valvinc/LEDruino-1.0/README.md

# LEDruino-1.0
Es empfiehlt sich das grosse Flussdiagram unter \grafiken\Fertig\ zum Verständnis zu studieren.
