valvinc/LEDruino-1.0/Arduino_Projektpräsentation.pdf

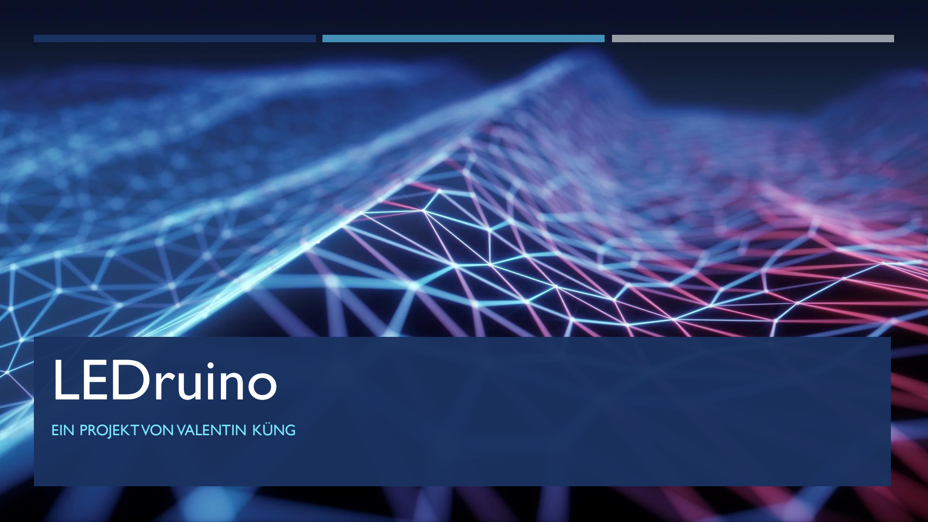
[picture p7: page 1]

# LEDruino

EIN PROJEKT VON VALENTIN KÜNG

### INHALT

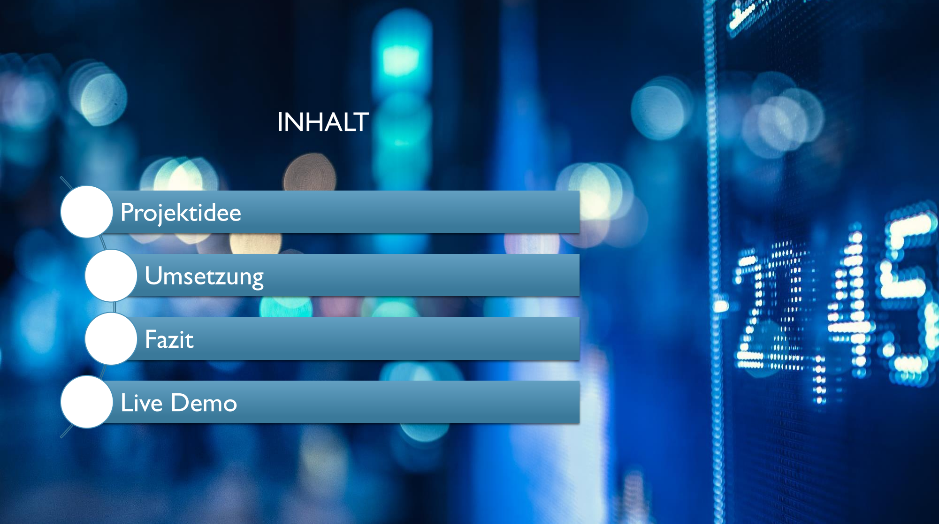
[picture p8: page 2]

### Projektidee

### Umsetzung

### Fazit

### Live Demo

### PROJEKTIDEE

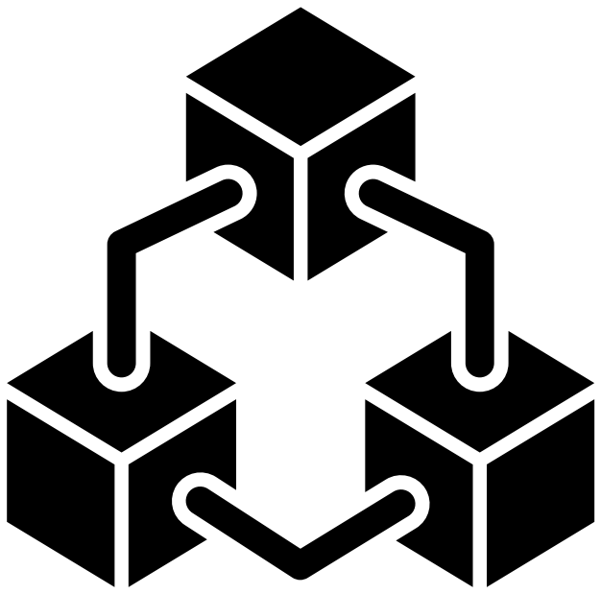
[picture p9: figure]

### PROJEKTIDEE

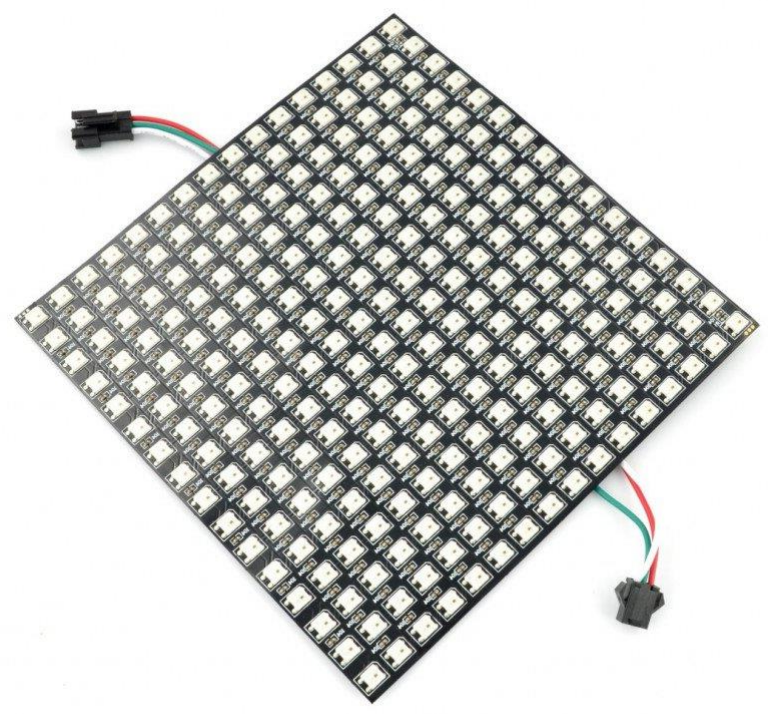
[picture p10: figure]

- LED-Kunstinstallation
- 16x16-LED-Matrix gesteuert von einem Arduino.
- Reaktion auf Umwelteinflüsse
- Kombination von Funktionalität und Ästhetik

### PLANUNG - FUNKTIONEN

- Anzeige von
- Nähe eines Objekts
- Licht
- Temperatur
- Geräusche
- Modi für einzelne Sensorendaten
- Modus für alle Sensorendaten zusammengefasst

### UMSETZUNG

### UMSETZUNG -WICHTIGE MODULE

- Hauptitereation - Setup() und Loop()
- LED und Sensoren Manager
- Inputs von Sensoren etc.
- Modi: Modul für Modi

### VEREINFACHTES FLUSSDIAGRAMM

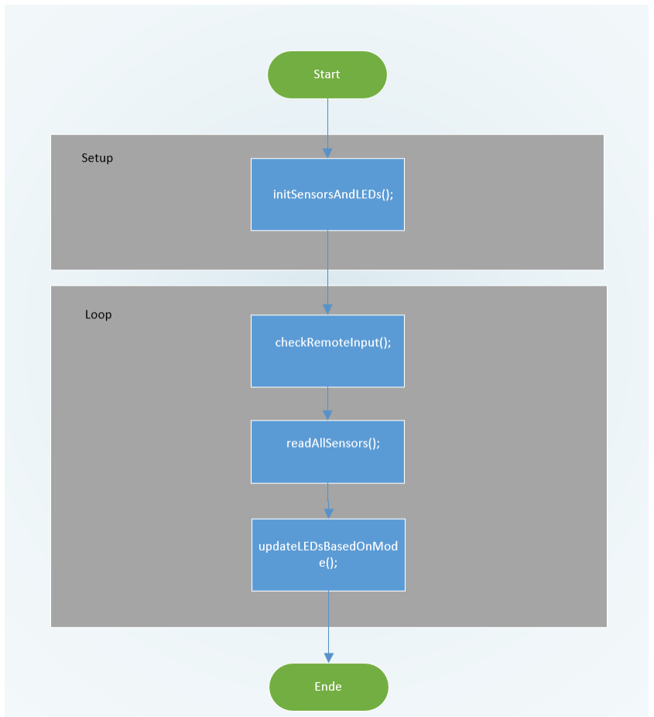
[picture p11: figure]

### UMSETZUNG - PHYSISCH

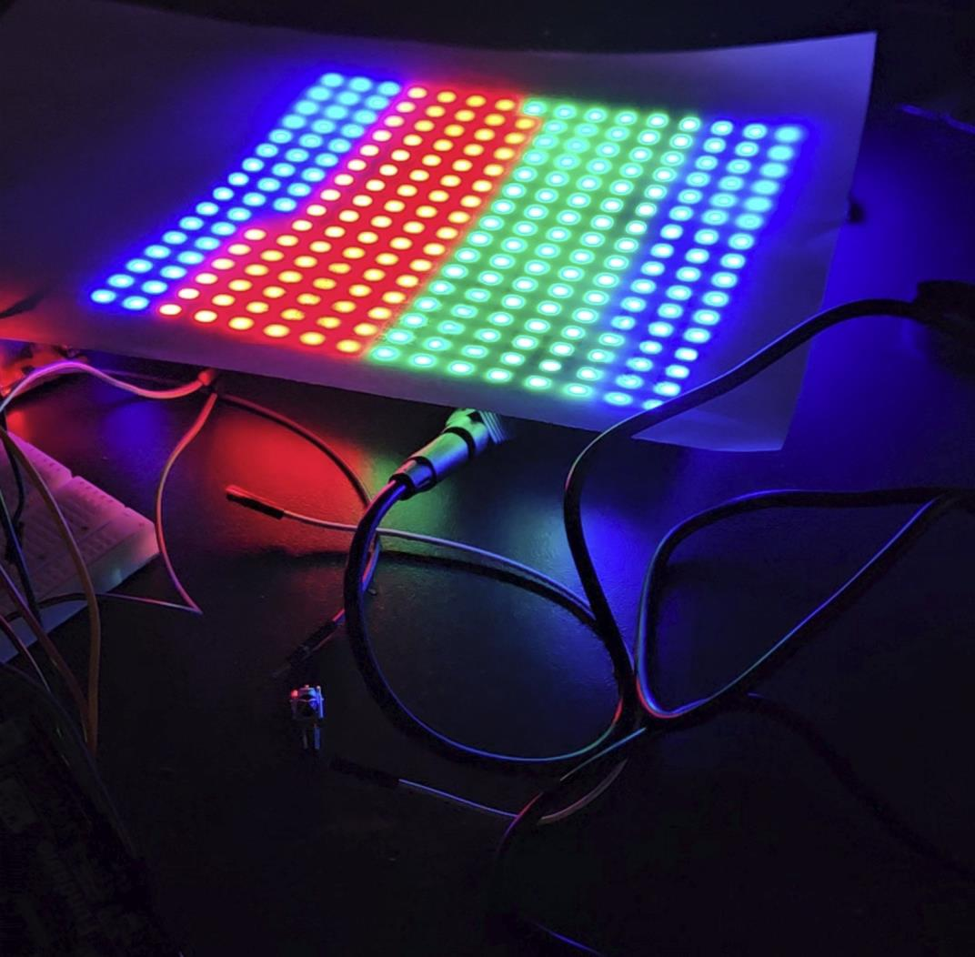
[picture p12: figure]

- Verkabelung
- Keypad
- Sensoren
- LED Matrix
- Stromversorgung LEDs

### UMSETZUNG – HERAUSFORDERUNGEN

- Echtzeitreaktion bei mehreren Sensoren
- Wertebereiche der Sensoren

### FAZIT

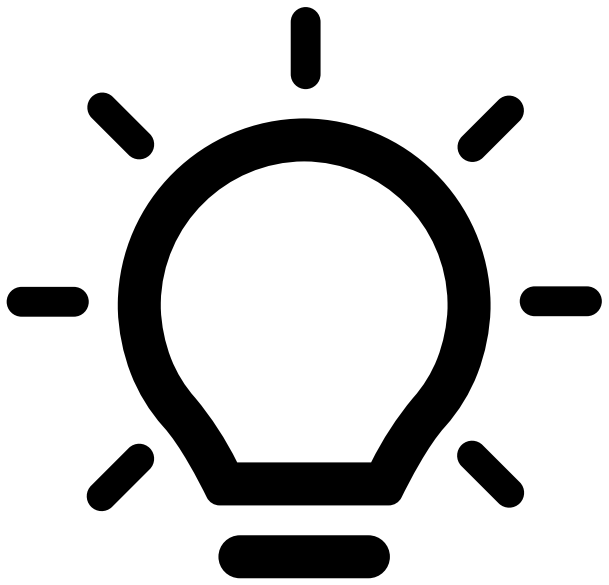
[picture p13: figure]

### FAZIT - ERKENNTNISSE

- Modulare Programmierung für einfache Erweiterungen
- Komplexität von innerhalb des Codes ist nicht zu unterschätzen
- Bedeutung von Zeitmanagement innerhalb des Codes

### FAZIT - ZUKUNFT

- Erstellung eines 3D-gedruckten Gehäuses
- Erweiterung um weitere Sensoren
- Animationen ausbauen

## LIVE DEMO
