valvinc/LEDruino-1.0/grafiken/Planung/Programmlogik_Planung.pdf

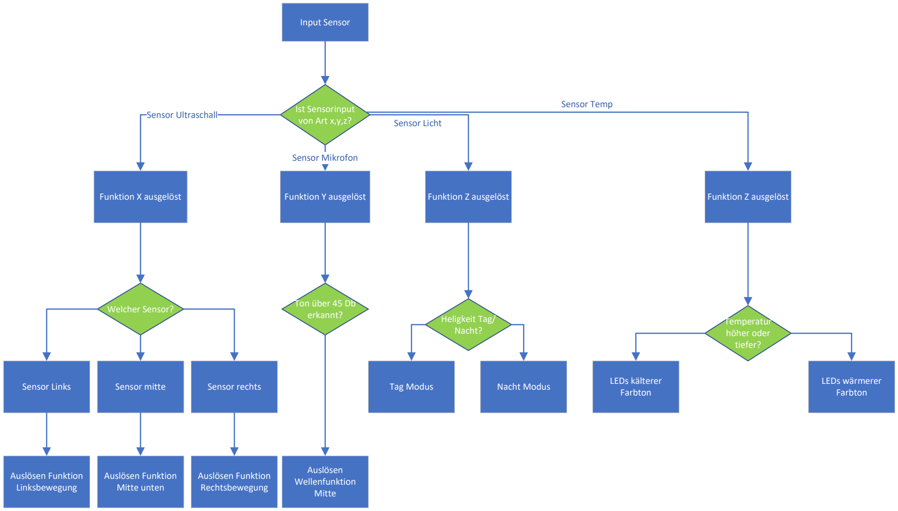
[picture p14: figure]
Input Sensor; Ist Sensorinput von Art x,y,z?; Funktion X ausgelöst; Funktion Y ausgelöst; Funktion Z ausgelöst; Sensor Ultraschall; Sensor Licht; Sensor Mikrofon; Sensor Temp; Sensor Links; Sensor mitte; Sensor rechts; LEDs wärmerer; Farbton Tag Modus; Temperatur höher oder tiefer?; Heligkeit Tag/ Nacht?; Ton über 45 Db erkannt?; Auslösen Wellenfunktion Mitte; LEDs kälterer Farbton; Welcher Sensor?; Nacht Modus; Auslösen Funktion Linksbewegung; Auslösen Funktion Mitte unten; Auslösen Funktion Rechtsbewegung
