valvinc/LEDruino-1.0/grafiken/Fertig/_main.pdf

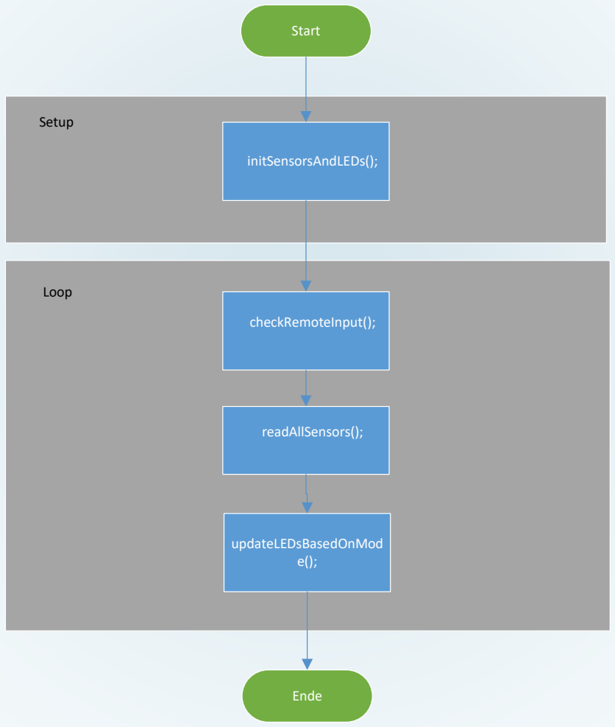
[picture p15: figure]
Start; initSensorsAndLEDs();; checkRemoteInput();; readAllSensors();; updateLEDsBasedOnMod e();; Ende; Setup; Loop
