valvinc/LEDruino-1.0/grafiken/Fertig/Programm_Gesamt.pdf

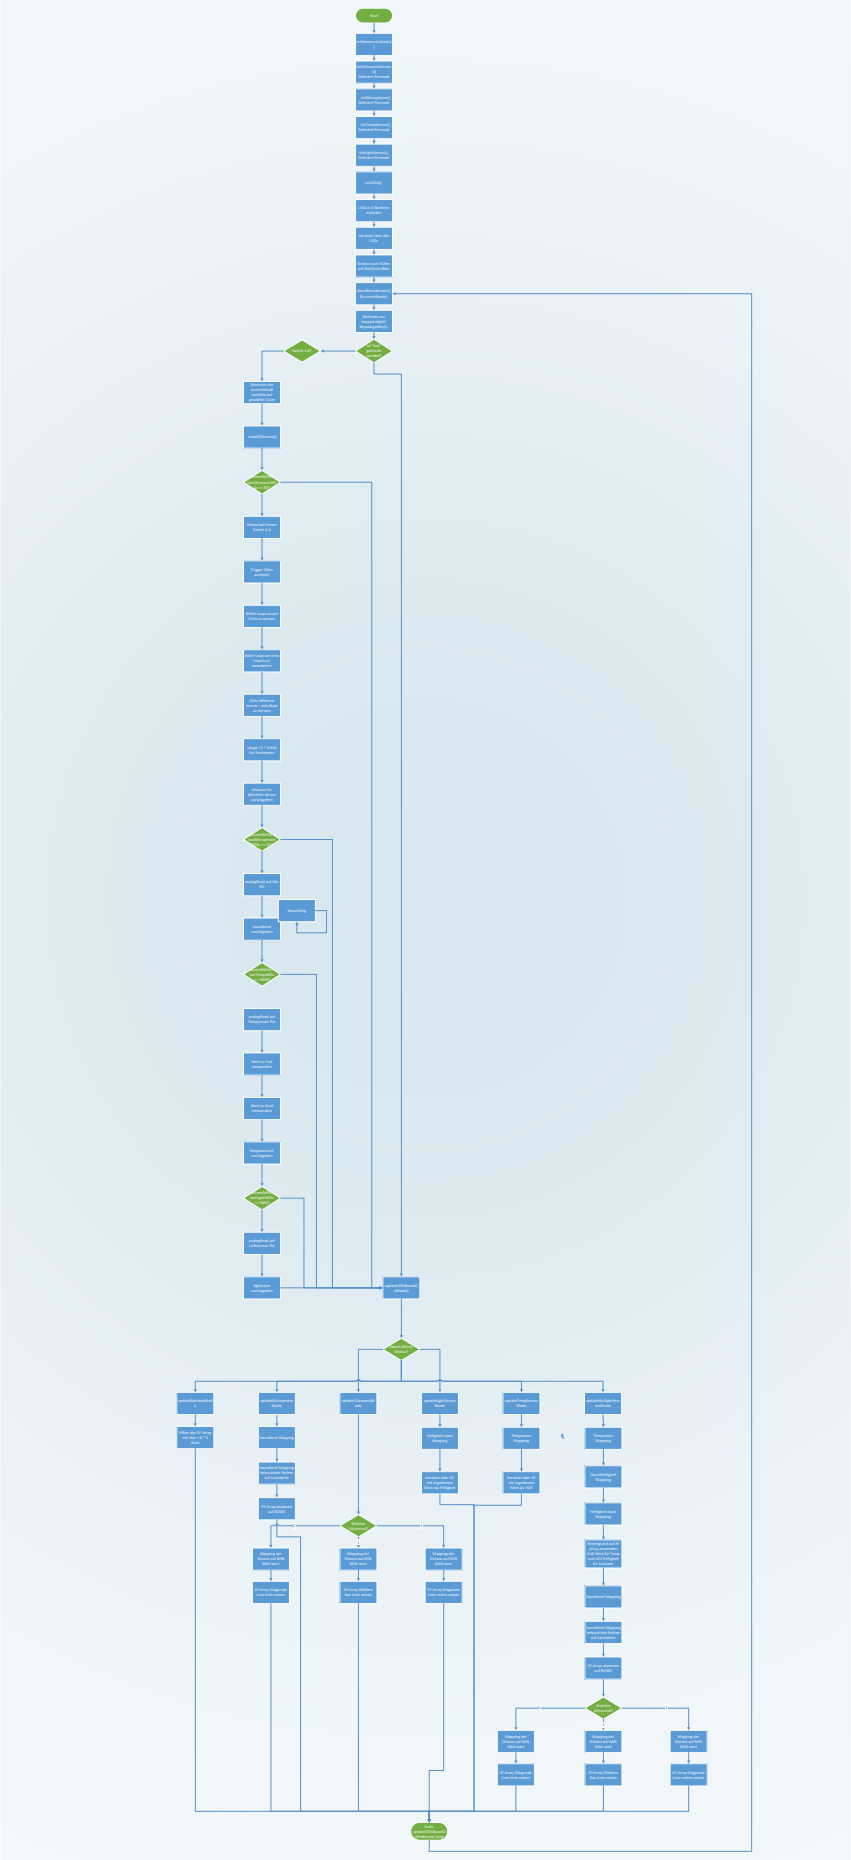
[picture p16: page 1]
Start; initSensorsAndLeds( ); InitUltrasonicSensor s() Definiert Pinmode; initMicrophone(); Definiert Pinmode; initTempSensor(); Definiert Pinmode; initLightSensor(); Definiert Pinmode; initLEDs();; checkRemoteInput( &currentMode);; Switch 1-6?; Wechseln der currentMode Variable auf gewählte Taste; Methode aus keypad objekt keypad.getKey();; Ist “key” gedrückt worden?; readAllSensors();; currentMillis – lastUltrasonicMil lis >= 50?; CurrentMillis - lastMicrophone Millis >= 10?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

LEDs in 3 Bereiche
einteilen

Iteration über alle
LEDs

Itration zum Füllen
mit Rot/Grün/Blau

While Loop um auf
Echo zu warten

While Loop um echo
Impuls zu
verarbeiten

analogRead auf Mic

Wert zu Volt
umwandeln

Wert zu Grad

Füllen des XY Array
mit Hue + 8 * X
Wert

Iteration über XY
mit ergebenem
Wert ala Helligkeit

Wert als HUE

XY Array anpassen
auf ROWS

Hintergrund auf XY
Array anwenden
HUE Wert für Temp
und LED Helligkeit
für Lichtwer

Mapping der
Distanz auf MIN
MAX wert

XY Array Diagonale
Linie links setzen

XY Array Mittlere
Box Linie setzen

Linie rechts setzen

Ende
updateLEDsBasedO
nMode und Loop
