valvinc/LEDruino-1.0/grafiken/Planung/Visuelles_Mockup_Case.pdf

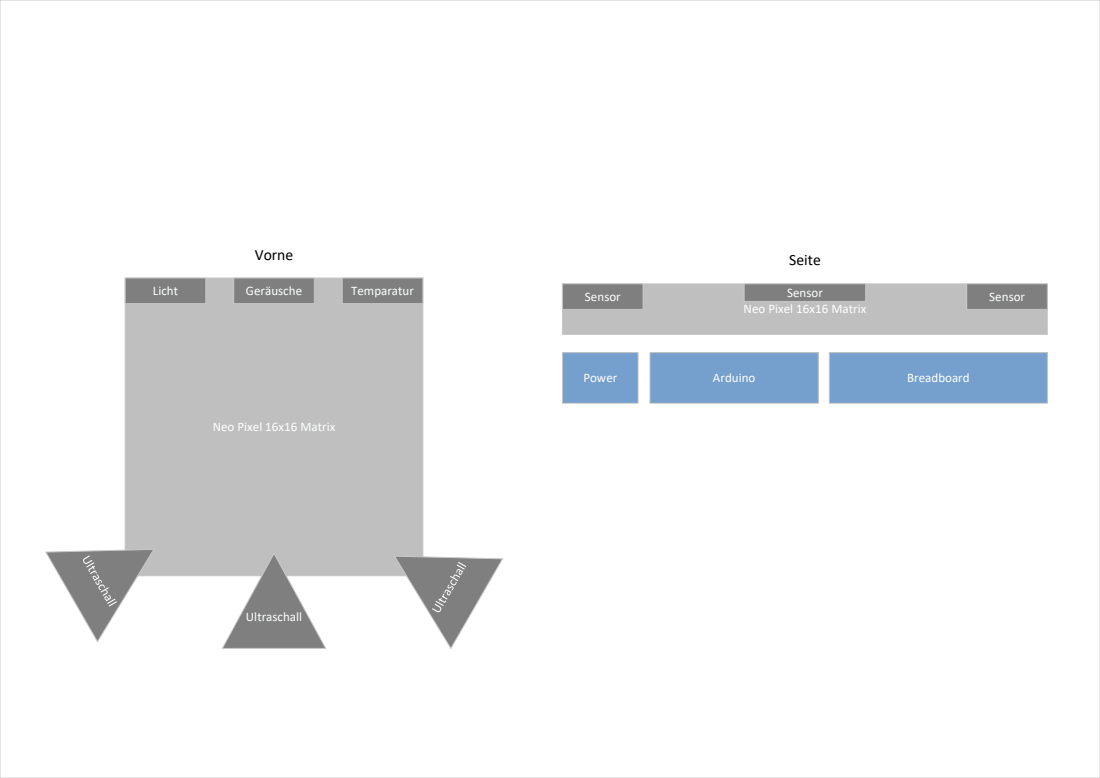
[picture p17: page 1]
Ultraschall; Power; Arduino; Breadboard; Vorne; Seite

Licht | Geräusche | Temparatur

Sensor | Sensor | Sensor

Neo Pixel 16x16 Matrix
