valvinc/LEDruino-1.0/(list of files, drawings)

Other design files:
grafiken/Planung/_elektronikschema.fzz
