valvinc/LEDruino-1.0/LEDudriono_V0.1-8LEDS/_main/_main.ino

#include "sensorLedManager.h"
#include "ledModule.h"
void setup() {
    Serial.begin(9600);
    initSensorsAndLEDs();
}

void loop() {
    updateSensorsAndLEDs();
    delay(50); // Small delay before the next measurement
}
